Schnibbz/yeti-dock/adapter-45/yeti-dock-adapter45-v7.step

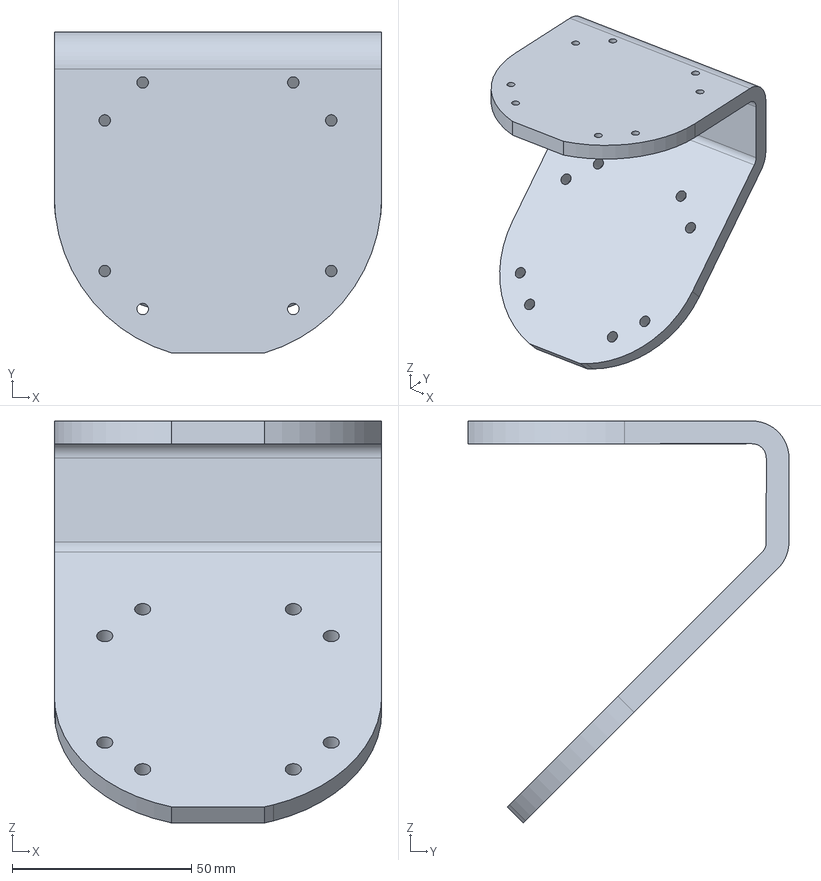
[picture p5: CAD file, 2026-10-27]
adapter-45/yeti-dock-adapter45-v7.step
91.4 x 89.6 x 112.3 mm
