Schnibbz/yeti-dock/bracket/yeti-dock-bracket-rev2-0.250-A36.dxf

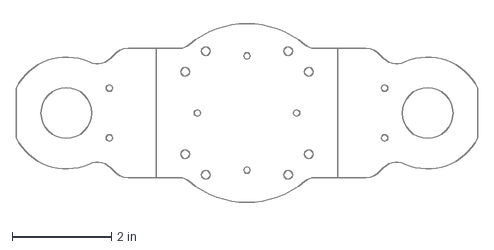
[picture p6: CAD file, 2026-10-27]
bracket/yeti-dock-bracket-rev2-0.250-A36.dxf
9.28 x 3.89 in
