Schnibbz/yeti-dock/pads/yeti-dock-pad-set-X1C-PETG.gcode.3mf

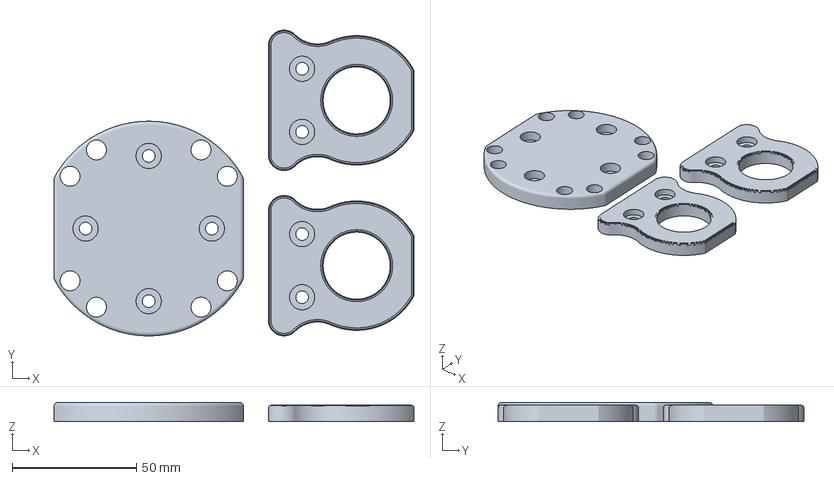
[picture p7: CAD file, 2026-10-28]
pads/yeti-dock-pad-set-X1C-PETG.gcode.3mf
144.8 x 123.0 x 7.75 mm
