Schnibbz/yeti-dock/adapter-45/yeti-dock-adapter45-v7-0.250-A36.dxf

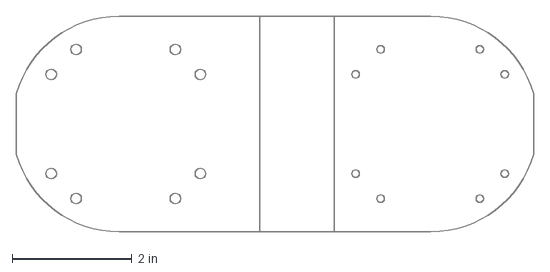
[picture p8: CAD file, 2026-10-27]
adapter-45/yeti-dock-adapter45-v7-0.250-A36.dxf
8.64 x 3.60 in
