Schnibbz/yeti-dock/bracket/yeti-dock-bracket-rev2.step

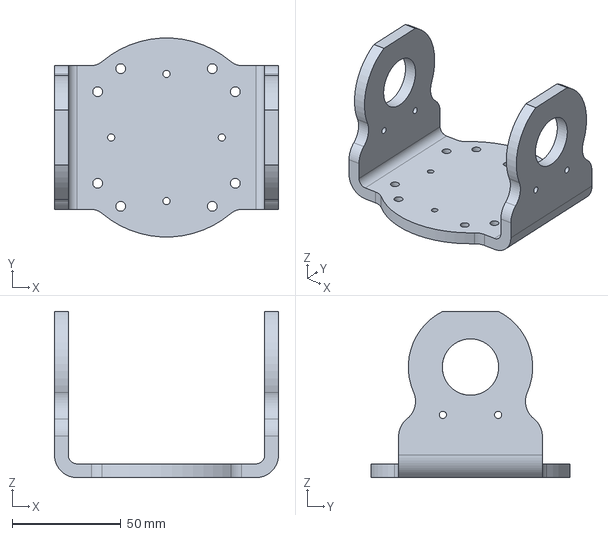
[picture p9: CAD file, 2026-10-27]
bracket/yeti-dock-bracket-rev2.step
102.9 x 91.3 x 76.4 mm
