Schnibbz/yeti-dock/pads/yeti-dock-side-pad.stl

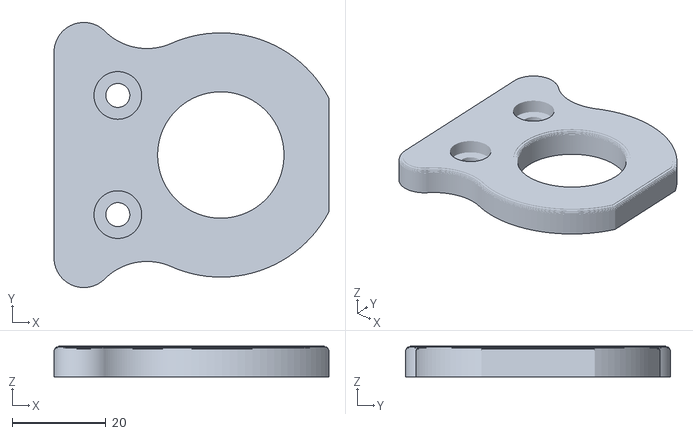
[picture p11: CAD file, 2026-10-27]
pads/yeti-dock-side-pad.stl
58.6 x 56.5 x 6.60
