Schnibbz/yeti-dock/pads/yeti-dock-web-pad-7.10.stl

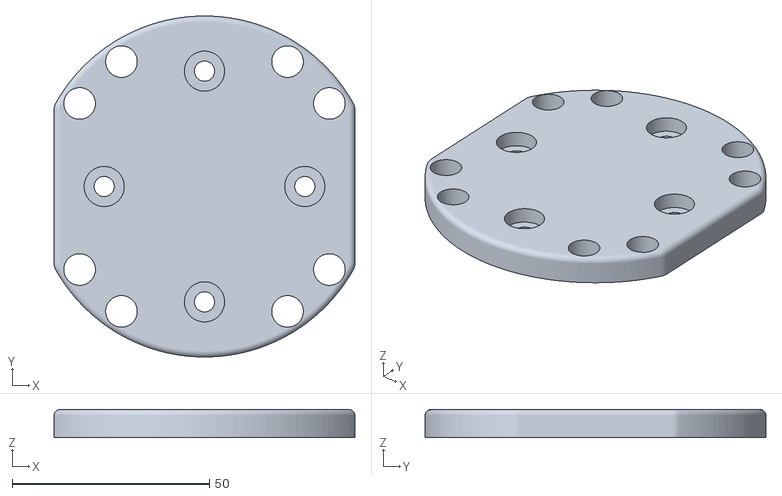
[picture p12: CAD file, 2026-10-27]
pads/yeti-dock-web-pad-7.10.stl
76.2 x 86.4 x 7.10
