Schnibbz/yeti-dock/(list of files, cad)

Other CAD files:
pads/yeti-dock-pad-set.stl
