Schnibbz/yeti-dock/(commit log)

2026-10-27 YETI DOCK v1.0: base bracket rev 2 + 45° adapter add-on, PETG pads, drill-and-tap guide
    [yeti-dock-adapter45-v7-0.250-A36.dxf, yeti-dock-adapter45-v7.step, yeti-dock-bracket-rev2-0.250-A36.dxf, yeti-dock-bracket-rev2.step, yeti-dock-pad-set.stl, yeti-dock-side-pad.stl, yeti-dock-web-pad-7.10.stl, yeti-dock-web-pad-7.75.stl]
2026-10-27 Ordering and finish: no shop tapping or coating; drill and tap everything, then clear coat or powder coat
2026-10-28 Pads: print solid (100 % infill, 5 walls)
2026-10-28 Pads: print-ready solid pad file for Bambu X1/P1
    [yeti-dock-pad-set-X1C-PETG.gcode.3mf]
